mobogojo/atx-case-mods/generated/AIO_240_Bracket_Base_Seg2_Front.stl

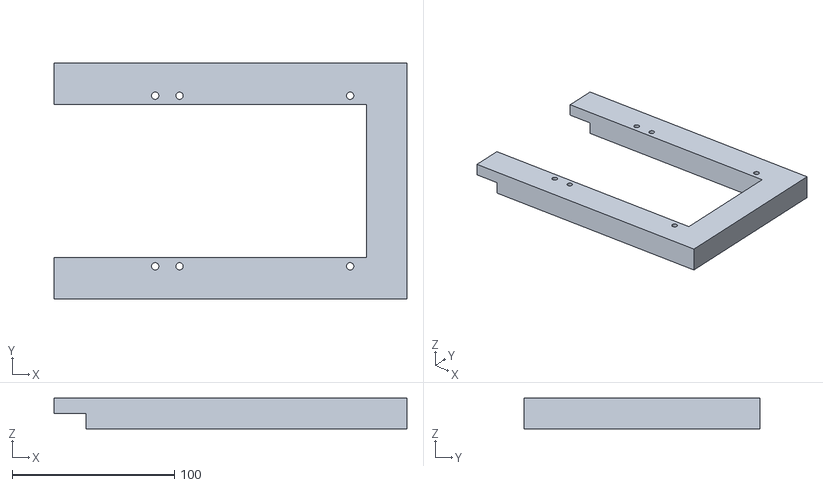
[picture p2: CAD file, 2026-10-16]
generated/AIO_240_Bracket_Base_Seg2_Front.stl
217.3 x 145.0 x 19.0
