mobogojo/atx-case-mods/generated/AIO_240_Bracket_Bezel.stl

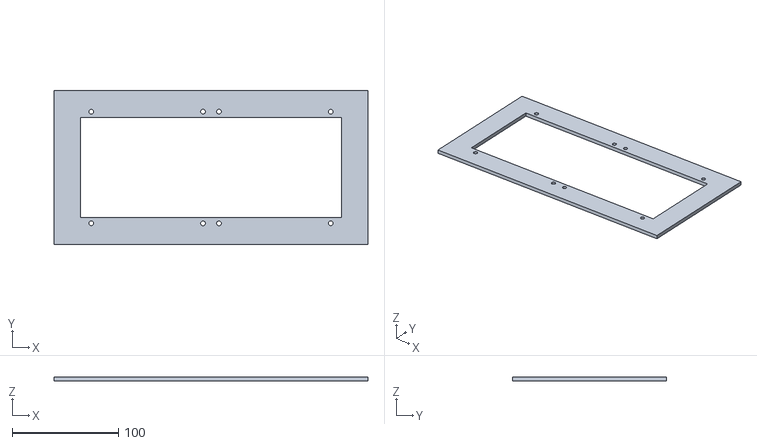
[picture p3: CAD file, 2026-10-16]
generated/AIO_240_Bracket_Bezel.stl
295.0 x 145.0 x 4.00
