mobogojo/atx-case-mods/generated/AIO_240_Bracket_Base.stl

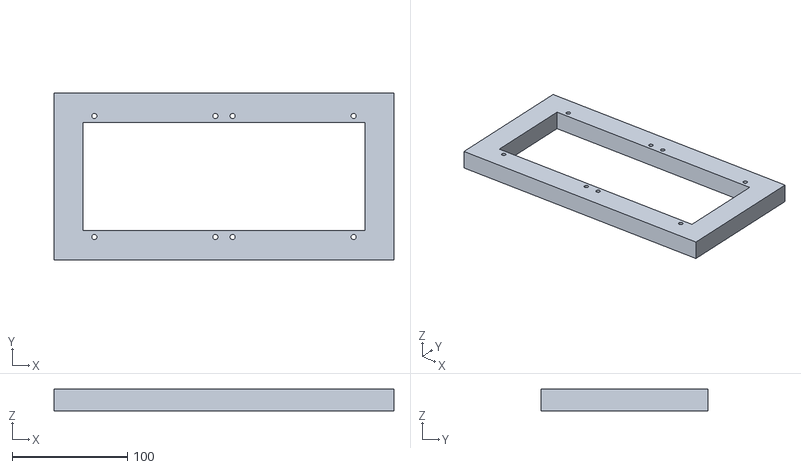
[picture p4: CAD file, 2026-10-16]
generated/AIO_240_Bracket_Base.stl
295.0 x 145.0 x 19.0
