mobogojo/atx-case-mods/generated/AIO_240_Bracket_Base_Seg1_Rear.stl

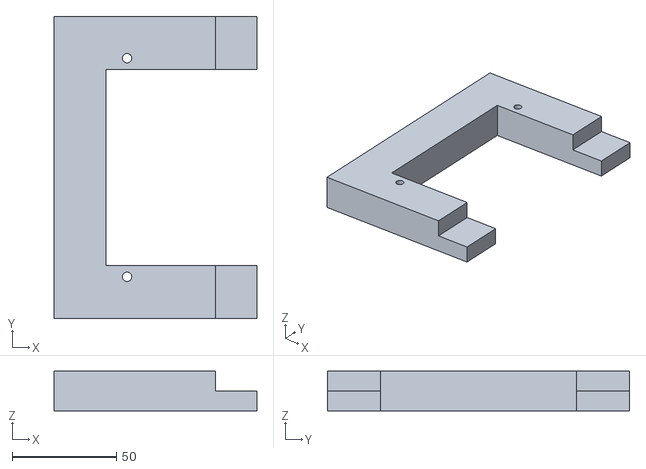
[picture p5: CAD file, 2026-10-16]
generated/AIO_240_Bracket_Base_Seg1_Rear.stl
97.3 x 145.0 x 19.0
