mobogojo/atx-case-mods/generated/AIO_360_Bracket_Base_Seg2_Front.stl

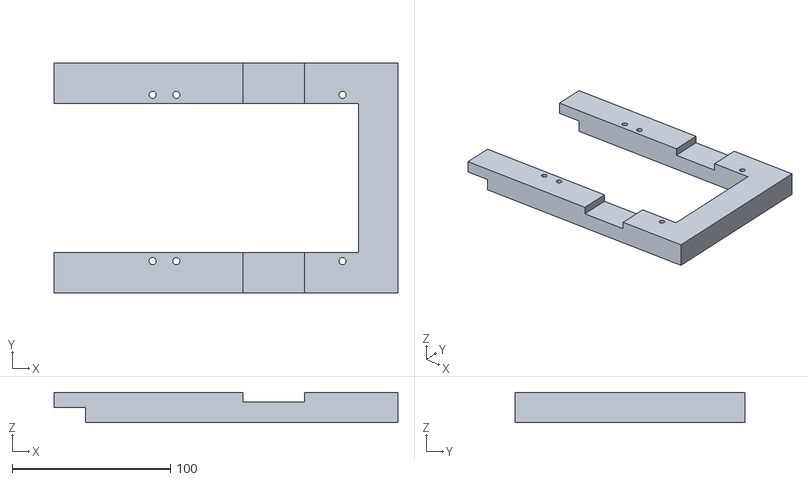
[picture p7: CAD file, 2026-10-14]
generated/AIO_360_Bracket_Base_Seg2_Front.stl
217.3 x 145.0 x 19.0
