mobogojo/atx-case-mods/generated/PSU_Sleeve.stl

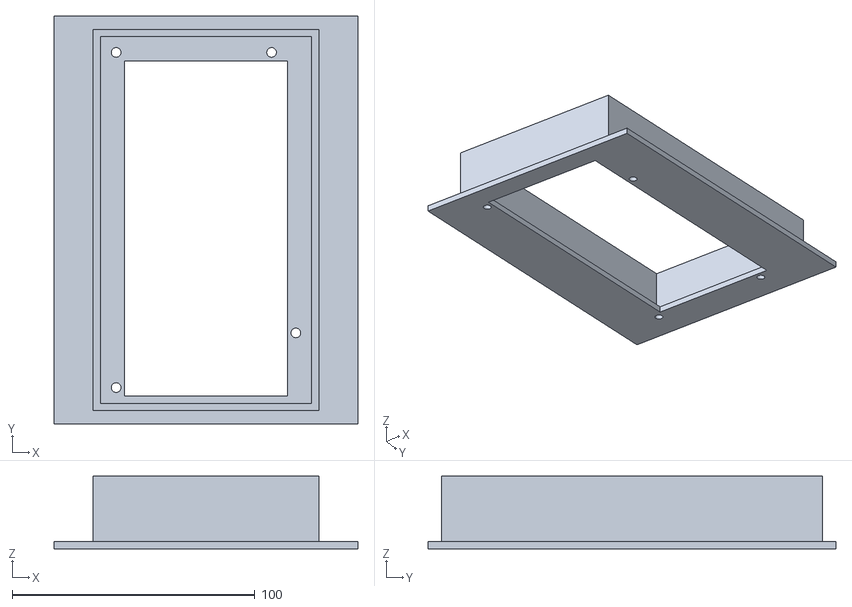
[picture p8: CAD file, 2026-10-12]
generated/PSU_Sleeve.stl
125.0 x 168.0 x 30.0
