mobogojo/atx-case-mods/(list of files, cad)

Other CAD files:
generated/AIO_360_Bracket_Base_Seg1_Rear.stl
generated/AIO_360_Bracket_Bezel_Seg2_Front.stl
generated/AIO_360_Bracket_Bezel_Seg1_Rear.stl
