mobogojo/atx-case-mods/(commit log)

2026-10-11 Add parametric Blender build framework and 360mm AIO bracket
    - casekit: context-free helpers (mm units, per-part collections, primitives,
    EXACT booleans, STL writer) that work over Blender MCP, in the UI and headless
    - parts/aio_360_bracket: 8mm base and 4mm bezel, fan grid, airflow cutout,
    shiplap segmentation for a 305mm bed, and validate() for spec problems
    - build.py CLI/helper, selftest.py geometry checks
    - README project overview, docs/aio-360-bracket.md spec, CLAUDE.md conventions
    Claude-Session: https://claude.ai/code/session_01VRvQFVq2f9xzXmqSFbRCxo
2026-10-11 Add 10mm base with pocket over the lid support rail
    - base_thickness 8 -> 10 mm; 5.5 mm deep pocket in the lid-facing face over the
    5 mm rail measured 308-325 mm from the rear wall (clearance split evenly)
    - validate() flags pocket depth, pocket vs fan holes, and joints through the pocket
    (the spec's X=+108.75 joint does)
    - selftest covers pocket position/volume and the recommended split_x=(0,)
    - docs: rail pocket section and open issues (pocket width vs 17 mm span,
    unmeasured rear-wall offset, bugs in the supplied pocket script)
    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
2026-10-11 Set rail pocket to 6 mm deep x 19 mm long
    Rail span 308-325 mm (17 mm) confirmed. Pocket depth 5.5 -> 6.0 mm (1 mm over
    the 5 mm rail, 4 mm floor) and clearance 1 -> 2 mm for a 19 mm pocket with room
    to adjust. Drop the resolved pocket-width open issue.
    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
2026-10-11 Document that the rail is measured from the outside rear face
    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
2026-10-11 Record donor case measurements from photos
    Lid ~437 x 200 mm, chassis ~440 mm long, cross support confirmed at 308-325 mm
    (17 mm wide). Flag that the radiator would hang over the 5.25in drive cage.
    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
2026-10-11 Update drive cage and PSU notes from test-fit photo
    A 120 mm radiator fits between the drive cage walls, so only drives in the bays
    block it. Note the cage inner width must clear the 145 mm base plate, and that
    the top-mounted PSU must be relocated.
    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
2026-10-11 Add lid and chassis inside widths from photos
    Lid ~192 mm between flanges, chassis ~195 mm inside at the top. Note that the
    drive cage walls stop under the cross support, so the plate's lower 5 mm must
    clear the cage's ~148 mm inside width.
    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
2026-10-11 Record PSU envelope and relocation options
    PSU needs 200 mm length with cables, so it can't lie flat in the ~150 mm front
    zone; standing it on end there or moving it to the floor are the options.
    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
2026-10-11 Start the plate 20 mm in from the rear wall for the PSU
    rear_wall_to_plate 0 -> 20 mm moves the rail pocket to X=119.5..138.5. Add
    case_length (440 mm) and joint_pocket_margin checks to validate(); the spec's
    X=+108.75 joint now ends 0.75 mm before the pocket and is flagged.
    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
2026-10-11 Make the 94 mm cutout and single X=0 split the defaults
    Fan holes now get a ~3 mm web, and each plate prints as two 217.3 mm pieces
    labelled Rear/Front; only the front base piece has the rail pocket. Builds with
    --strict and no warnings. Docs split into Still open / Resolved.
    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
2026-10-12 Add PSU sleeve part for the rear fan opening
    Sleeve holds a Corsair RM850 on its side: 87 x 151 mm inside (0.5 mm per side),
    3 mm walls, 300 mm long, on a 125 x 168 x 4 mm flange with a 105 mm fan hole
    pattern and a 140 mm window for the PSU fan. casekit.cylinder gains an axis
    argument. validate() flags the 300 mm height against an assumed 254 mm printer Z.
    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
2026-10-12 Make the PSU sleeve a 30 mm seat clamped by the PSU screws
    Length 300 -> 30 mm. Add a 3 mm seat at the rear (10 mm top/sides, 3 mm bottom
    to clear the switch) with four #6-32 PSU screw holes, so the PSU screws clamp
    PSU, seat and case wall together. Fan-slot holes and the fan window become
    opt-in. validate() checks the screw holes land on the seat.
    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
2026-10-12 Move PSU sleeve screw hole up 12.5 mm and add hardware doc + generated STLs
    Move the lower "Left, low" PSU screw hole from 134 mm to 121.5 mm from the
    top, per a fit check. Rebuilt the sleeve STL; selftest passes.
    Add docs/hardware.md documenting the Corsair RM850 PSU and the donor ATX
    case these parts were designed around, and link it from the README.
    Check in ready-to-slice STLs under generated/ (PSU sleeve + both AIO
    bracket plates, segmented for a 305 mm bed). out/ stays the gitignored
    local export directory.
    [AIO_360_Bracket_Base_Seg1_Rear.stl, AIO_360_Bracket_Base_Seg2_Front.stl, AIO_360_Bracket_Bezel_Seg1_Rear.stl, AIO_360_Bracket_Bezel_Seg2_Front.stl, PSU_Sleeve.stl]
2026-10-14 Raise AIO base to 0.75 in and widen the rail pocket to clear the bar
    Two pre-print fit changes to the AIO bracket base, from a test fit:
    - base_thickness 10 -> 19.05 mm (a full 0.75 in standoff). The 6 mm rail
    pocket is unchanged, so the floor under it goes 4 -> 13.05 mm.
    - pocket_clearance 2 -> 22 mm, widening the lid-rail pocket from 19 to
    39 mm (11 mm slack each side of the 17 mm rail) so the base drops over
    the support bar instead of squeezing around it.
    Pin pocket_clearance=2 on the selftest SPEC case so it keeps documenting
    the original 119.5..138.5 pocket and the 0.75 mm joint margin; the
    defaults case now exercises the wider pocket. Selftest passes. Rebuilt
    and refreshed the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
    [AIO_360_Bracket_Base_Seg1_Rear.stl, AIO_360_Bracket_Base_Seg2_Front.stl]
2026-10-16 Add a 240 mm AIO bracket (2 fans, one-piece printable)
    A two-fan sibling of the 360 bracket for a 240 mm radiator. Same base/
    bezel sandwich and fan grid, but:
    - 295 x 145 mm plate, so it fits the 305 mm Airwolf bed in ONE piece; no
    split required. An optional two-piece split is on a fan centreline at
    X=-60 (not the middle, where the inner holes at X=+/-7.5 would foul a
    central lap), giving unequal 97.3 + 217.3 mm halves with every hole
    clear of the seam.
    - No lid-rail pocket: a 295 mm plate 20 mm behind the rear wall only
    clips the front edge of the 308-325 mm support rail, so the pocket
    doesn't apply. The reference build cuts that bar out; docs cover the
    keep-the-bar options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
    [AIO_240_Bracket_Base.stl, AIO_240_Bracket_Base_Seg1_Rear.stl, AIO_240_Bracket_Base_Seg2_Front.stl, AIO_240_Bracket_Bezel.stl, AIO_240_Bracket_Bezel_Seg1_Rear.stl, AIO_240_Bracket_Bezel_Seg2_Front.stl]
